TzarRusi/Lin-Control/docs/hardware.md

# Аппаратная часть

## Компоненты

- STM32F103C8T6 Blue Pill;
- ST-Link V2 для прошивки;
- LIN-трансивер TJA1021T/20 (`1021T2c`);
- источник 12 В с защитой силовой ветви;
- подтяжки 4,7 кОм и 10 кОм;
- master pull-up LIN с диодом;
- развязывающий конденсатор 100 нФ;
- USB-кабель для питания STM32 и CDC-связи.

## Соединения TJA1021

| Pin TJA1021 | Соединение |
|---:|---|
| 1 RXD | PA3 STM32, подтяжка 4,7 кОм к 3,3 В |
| 2 SLP_N | PB0 STM32, подтяжка 10 кОм к 3,3 В |
| 3 WAKE | соединён с VBAT согласно стендовой схеме |
| 4 TXD | PA2 STM32 |
| 5 GND | общая земля STM32, трансивера и устройства |
| 6 LIN | LIN устройства и master pull-up |
| 7 VBAT | +12 В, 100 нФ на GND рядом с трансивером |
| 8 INH | не используется |

Узел master pull-up: `VBAT → диод → резистор → LIN`. Ориентацию диода и номинал резистора следует сверять с типовой схемой TJA1021.

## Управление источником

`PB12` соединён с `PS_ON` ATX-источника. Выход STM32 работает как open drain:

- активный LOW — запрос включения;
- отпущенный выход — выключение;
- firmware lease длится 3000 мс;
- `POWER KEEP` продлевает lease;
- потеря USB/DTR, ошибка UART, ошибка эха или таймаут снимают запрос питания.

`POWER?` показывает логический запрос контроллера, а не измеряет напряжение 12 В.

## Контрольные напряжения

Перед обменом на собранном стенде подтверждены:

| Точка | Ожидаемое значение |
|---|---:|
| TJA1021 pin 7 | около 12 В |
| LIN, pin 6 в покое | около 12 В |
| SLP_N, pin 2 до включения | около 0 В |
| RXD, pin 1 / PA3 | около 3,3 В |

## Порядок запуска

1. Проверить общую землю и отсутствие короткого замыкания LIN/VBAT.
2. Подключить ST-Link только к SWDIO, SWCLK и GND; STM32 питать собственным USB.
3. Подключить TJA1021 и LIN-устройство.
4. Подать 12 В на силовую часть.
5. Проверить `PING`, `INFO`, затем `POLL 14`.
6. При любой ошибке выполнить `STOP` и снять 12 В.
