TzarRusi/Lin-Control/docs/references.md

# Источники

- NXP TJA1021 — LIN 2.2A/SAE J2602 transceiver: https://www.nxp.com/docs/en/data-sheet/TJA1021.pdf
- LIN Specification Package 2.2A: https://www.lin-cia.org/fileadmin/microsites/lin-cia.org/resources/documents/LIN-Spec_Pac2_2A.pdf
- AUTOSAR E2E Protocol Specification: https://www.autosar.org/fileadmin/standards/R24-11/FO/AUTOSAR_FO_PRS_E2EProtocol.pdf
- STM32F103 reference manual RM0008: https://www.st.com/resource/en/reference_manual/cd00171190.pdf
- STM32duino Arduino core: https://github.com/stm32duino/Arduino_Core_STM32
